Jan-IngenHousz-Institute/poroGO/kiCAD/poroGO/BOM_poroGO.xlsx

Sheet: BOM
Item name | Supplier product no | Supplier link/Item name | Quantity
Capacitor 2.2uF 0603 25V X5R 10% (Murata GRM188R61E225KA12D) | 490-10731-1-ND | https://www.digikey.nl/en/products/result?keywords=490-10731-1-ND | 80
Capacitor 10uF 0603 25V X5R 20% (Murata GRM188R61E106MA73D) | 490-7202-1-ND | https://www.digikey.nl/en/products/result?keywords=490-7202-1-ND | 30
Capacitor 10uF 0805 35V X5R 10% (TDK C2012X5R1V106K085AC) | 445-14417-1-ND | https://www.digikey.nl/en/products/result?keywords=445-14417-1-ND | 10
Capacitor 1nF 0603 50V X7R 10% (Samsung CL10B102KB8NNNC) | 1276-1018-1-ND | https://www.digikey.nl/en/products/result?keywords=1276-1018-1-ND | 10
Capacitor 1uF 0603 25V X7R 10% (Wurth 885012206076) | 732-7994-1-ND | https://www.digikey.nl/en/products/result?keywords=732-7994-1-ND | 40
Capacitor 100pF 0603 50V C0G 5% (Samsung CL10C101JB8NNNC) | 1276-1008-1-ND | https://www.digikey.nl/en/products/result?keywords=1276-1008-1-ND | 10
Resistor 5.1k 0603 1% (Bourns CR0603-FX-5101ELF) | CR0603-FX-5101ELFCT-ND | https://www.digikey.nl/en/products/result?keywords=CR0603-FX-5101ELF | 50
Resistor 6.8k 0603 1% (Bourns CR0603-FX-6801ELF) | CR0603-FX-6801ELFCT-ND | https://www.digikey.nl/en/products/result?keywords=CR0603-FX-6801ELF | 10
Resistor 187k 0603 1% (Bourns CR0603-FX-1873ELF) | 118-CR0603-FX-1873ELFCT-ND | https://www.digikey.nl/en/products/result?keywords=CR0603-FX-1873ELF | 10
Resistor 100k 0603 1% (Bourns CR0603-FX-1003ELF) | CR0603-FX-1003ELFCT-ND | https://www.digikey.nl/en/products/result?keywords=CR0603-FX-1003ELF | 20
Resistor 15R 0603 1% (Bourns CR0603-FX-15R0ELF) | CR0603-FX-15R0ELFCT-ND | https://www.digikey.nl/en/products/result?keywords=CR0603-FX-15R0ELF | 10
Resistor 1.5k 0603 1% (Bourns CR0603-FX-1501ELF) | 118-CR0603-FX-1501ELFCT-ND | https://www.digikey.nl/en/products/result?keywords=CR0603-FX-1501ELF | 10
Resistor 270k 0603 1% (Yageo RC0603FR-07270KL) | 311-270KHRCT-ND | https://www.digikey.nl/en/products/result?keywords=RC0603FR-07270KL | 10
Resistor 100R 0603 1% (Bourns CR0603-FX-1000ELF) | CR0603-FX-1000ELFCT-ND | https://www.digikey.nl/en/products/result?keywords=CR0603-FX-1000ELF | 10
Resistor 39k 0603 1% (Bourns CR0603-FX-3902ELF) | CR0603-FX-3902ELFCT-ND | https://www.digikey.nl/en/products/result?keywords=CR0603-FX-3902ELF | 10
Resistor 4.7k 0603 1% (Bourns CR0603-FX-4701ELF) | CR0603-FX-4701ELFCT-ND | https://www.digikey.nl/en/products/result?keywords=CR0603-FX-4701ELF | 20
Diode 1N4148W SOD-123 (Slkormicro) | 21853071-ND | https://www.digikey.nl/en/products/detail/smc-diode-solutions/1N4148W/6022450 | 10
Schottky diode 1N5819W 40V 1A SOD-123FL (Slkormicro) | 26112808-ND | https://www.digikey.nl/en/products/detail/smc-diode-solutions/1N5819W/15964237 | 10
LED green 0805 (Lite-On LTST-C171KGKT) | 160-1426-1-ND | https://www.digikey.nl/en/products/result?keywords=LTST-C171KGKT | 10
Inductor 10uH 3x3x1.5mm shielded (Bourns SRN3015TA-100M) | SRN3015TA-100MCT-ND | https://www.digikey.nl/en/products/result?keywords=SRN3015TA-100M | 10
Crystal 40MHz 2016 4-pin 8pF (Eaton E9X400081G08) | ECS-400-6-47B2-CKM-TR | https://www.digikey.nl/en/products/detail/ecs-inc/ecs-400-6-47b2-ckm-tr/20534431 | 10
Dual NPN/PNP transistor 40V W-DFN3020-8 (Diodes ZXTC4591AMCQTA) | 31-ZXTC4591AMCQTACT-ND | https://www.digikey.nl/en/products/result?keywords=ZXTC4591AMCQTA | 10
Spectral sensor AS7341-DLGM (ams OSRAM) | AS7341-DLGMCT-ND | https://www.digikey.nl/en/products/result?keywords=AS7341-DLGM | 10
USB ESD protection IP4234CZ6,115 (Nexperia) | 1727-1217-1-ND | https://www.digikey.nl/en/products/result?keywords=IP4234CZ6,115 | 10
Boost converter MT3608 SOT-23-6 (Olimex resale) - NOT IN STOCK | 1188-SMDICMT3608-ND | https://www.digikey.nl/en/products/result?keywords=1188-SMDICMT3608-ND | 10
Op-amp LM7321QMFX/NOPB SOT-23-5 (TI) | 296-LM7321QMFX/NOPBCT-ND | https://www.digikey.nl/en/products/result?keywords=LM7321QMFX/NOPB | 10
Sensor BME280 (Bosch Sensortec) - NOT IN STOCK, backorder | 828-1063-1-ND | https://www.digikey.nl/en/products/result?keywords=828-1063-1-ND | 10
Dual LDO 1.8V/3.3V AP7312-1833W6-7 (Diodes Inc) | AP7312-1833W6-7DICT-ND | https://www.digikey.nl/en/products/result?keywords=AP7312-1833W6-7 | 10
SoC ESP8685H4 QFN-28 (Espressif) | 1965-ESP8685H4CT-ND | https://www.digikey.nl/en/products/result?keywords=ESP8685H4 | 10
USB-C receptacle 16-pin top mount 12402012E212A (Amphenol ICC) | 664-12402012E212ACT-ND | https://www.digikey.nl/en/products/result?keywords=12402012E212A | 10
Pin header 1x02 2.54mm vertical THT (Sullins PRPC002SAAN-RC) | 35-PRPC002SAAN-RC-ND | https://www.digikey.nl/en/products/result?keywords=PRPC002SAAN-RC | 10

Sheet: Details
# | References | Value / Description | Manufacturer | MPN | Supplier | Supplier product no | Link | Qty per board | Qty (10 boards) | Order qty | Unit price EUR | Extended EUR | Stock | Notes
1 | C1,C2,C3,C4,C9,C10,C11,C12 | 2.2uF 0603 X5R 25V 10% | Murata | GRM188R61E225KA12D | DigiKey NL | 490-10731-1-ND | https://www.digikey.nl/en/products/result?keywords=490-10731-1-ND | 8 | 80 | 80 | €0.0306 | €2.45 | 156,080 | Schematic MPN GRT188R61H225KE13D (50V) is in stock at DigiKey but costs 0.0656 EUR; 25V rating is sufficient for 3.3V/5V rails. Price at 50+ break.
2 | C6,C13,C201 | 10uF 0603 X5R 25V 20% | Murata | GRM188R61E106MA73D | DigiKey NL | 490-7202-1-ND | https://www.digikey.nl/en/products/result?keywords=490-7202-1-ND | 3 | 30 | 30 | €0.1410 | €4.23 | 302,052 | Schematic MPN GRM188R61E106MA73J out of stock everywhere; MA73D is the same part with 20% tolerance. C13 in schematic wrongly carries the 2.2uF MPN. Farnell 1907503 lists it at ~0.0955 EUR (MOQ 10) but could not be verified (site blocked).
3 | C203 | 10uF 0805 X5R 35V 10% (boost output, up to 28V) | TDK | C2012X5R1V106K085AC | DigiKey NL | 445-14417-1-ND | https://www.digikey.nl/en/products/result?keywords=445-14417-1-ND | 1 | 10 | 10 | €0.2480 | €2.48 | 137,592 | No MPN in schematic; 35V rating chosen because boost output goes to 20-28V. DigiKey flags this TDK part NRND; active alternative Taiyo Yuden GMK212BBJ106MG-T (587-4894-1-ND) 0.273 EUR.
4 | C202 | 1nF 0603 X7R 50V 10% | Samsung | CL10B102KB8NNNC | DigiKey NL | 1276-1018-1-ND | https://www.digikey.nl/en/products/result?keywords=1276-1018-1-ND | 1 | 10 | 10 | €0.0290 | €0.29 | 1,036,225 | No MPN in schematic. Farnell 3013403 ~0.0163 EUR (unverified).
5 | C204,C205,C206,C208 | 1uF 0603 X7R 25V 10% | Wurth Elektronik | 885012206076 | DigiKey NL | 732-7994-1-ND | https://www.digikey.nl/en/products/result?keywords=732-7994-1-ND | 4 | 40 | 50 | €0.0398 | €1.99 | 72,775 | No MPN in schematic; Murata GRM188R61E105KA12D and Samsung CL10A105KA8NNNC out of stock. Ordering 50 (50+ break, 1.99 EUR) is cheaper than 40 at 0.057 (2.28 EUR).
6 | C207 | 100pF 0603 C0G/NP0 50V 5% | Samsung | CL10C101JB8NNNC | DigiKey NL | 1276-1008-1-ND | https://www.digikey.nl/en/products/result?keywords=1276-1008-1-ND | 1 | 10 | 10 | €0.0280 | €0.28 | 802,543 | No MPN in schematic. Farnell 3013439 ~0.0164 EUR (unverified).
7 | R2,R12,R13,R29,R30 | 5.1 kOhm 0603 1% 0.1W | Bourns | CR0603-FX-5101ELF | DigiKey NL | CR0603-FX-5101ELFCT-ND | https://www.digikey.nl/en/products/result?keywords=CR0603-FX-5101ELF | 5 | 50 | 50 | €0.0102 | €0.51 | 49,626 | Designer's MPN; 50+ price break.
8 | R201 | 6.8 kOhm 0603 1% 0.1W | Bourns | CR0603-FX-6801ELF | DigiKey NL | CR0603-FX-6801ELFCT-ND | https://www.digikey.nl/en/products/result?keywords=CR0603-FX-6801ELF | 1 | 10 | 10 | €0.0180 | €0.18 | 50,648
9 | R202 | 187 kOhm 0603 1% 0.1W | Bourns | CR0603-FX-1873ELF | DigiKey NL | 118-CR0603-FX-1873ELFCT-ND | https://www.digikey.nl/en/products/result?keywords=CR0603-FX-1873ELF | 1 | 10 | 10 | €0.0230 | €0.23 | 24,971
10 | R203,R204 | 100 kOhm 0603 1% 0.1W | Bourns | CR0603-FX-1003ELF | DigiKey NL | CR0603-FX-1003ELFCT-ND | https://www.digikey.nl/en/products/result?keywords=CR0603-FX-1003ELF | 2 | 20 | 20 | €0.0180 | €0.36 | 1,013,144
11 | R205 | 15 Ohm 0603 1% 0.1W | Bourns | CR0603-FX-15R0ELF | DigiKey NL | CR0603-FX-15R0ELFCT-ND | https://www.digikey.nl/en/products/result?keywords=CR0603-FX-15R0ELF | 1 | 10 | 10 | €0.0200 | €0.20 | 57,113
12 | R206 | 1.5 kOhm 0603 1% 0.1W | Bourns | CR0603-FX-1501ELF | DigiKey NL | 118-CR0603-FX-1501ELFCT-ND | https://www.digikey.nl/en/products/result?keywords=CR0603-FX-1501ELF | 1 | 10 | 10 | €0.0180 | €0.18 | 159,579
13 | R207 | 270 kOhm 0603 1% 0.1W | Yageo | RC0603FR-07270KL | DigiKey NL | 311-270KHRCT-ND | https://www.digikey.nl/en/products/result?keywords=RC0603FR-07270KL | 1 | 10 | 10 | €0.0210 | €0.21 | 235,572
14 | R208 | 100 Ohm 0603 1% 0.1W | Bourns | CR0603-FX-1000ELF | DigiKey NL | CR0603-FX-1000ELFCT-ND | https://www.digikey.nl/en/products/result?keywords=CR0603-FX-1000ELF | 1 | 10 | 10 | €0.0180 | €0.18 | 718,115
15 | R210 | 39 kOhm 0603 1% 0.1W | Bourns | CR0603-FX-3902ELF | DigiKey NL | CR0603-FX-3902ELFCT-ND | https://www.digikey.nl/en/products/result?keywords=CR0603-FX-3902ELF | 1 | 10 | 10 | €0.0230 | €0.23 | 37,369
16 | R211,R212 | 4.7 kOhm 0603 1% 0.1W | Bourns | CR0603-FX-4701ELF | DigiKey NL | CR0603-FX-4701ELFCT-ND | https://www.digikey.nl/en/products/result?keywords=CR0603-FX-4701ELF | 2 | 20 | 20 | €0.0180 | €0.36 | 267,757
17 | D1 | 1N4148W 75V 150mA switching diode SOD-123 | Shenzhen Slkormicro | 1N4148W | DigiKey NL | 21853071-ND | https://www.digikey.nl/en/products/result?keywords=21853071-ND | 1 | 10 | 10 | €0.0300 | €0.30 | 75,674 | Direct DigiKey stock (not marketplace). Schematic MPN MCC 1N4148W-TP: 0 stock at Farnell; brand alternative SMC 1N4148W (1655-1N4148WCT-ND) 0.071 EUR.
18 | D201 | Schottky 40V 1A SOD-123F/FL (boost output diode) | Shenzhen Slkormicro | 1N5819W | DigiKey NL | 26112808-ND | https://www.digikey.nl/en/products/result?keywords=26112808-ND | 1 | 10 | 10 | €0.0390 | €0.39 | 24,305 | Schematic value only says 'Schottky >100mA, SOD-123F'. Brand alternatives: SMC 1N5819W (1655-1N5819WCT-ND) 0.119 EUR; onsemi MBR140SFT1G 0.317 EUR.
19 | D3 | LED green 0805 | Lite-On | LTST-C171KGKT | DigiKey NL | 160-1426-1-ND | https://www.digikey.nl/en/products/result?keywords=LTST-C171KGKT | 1 | 10 | 10 | €0.0930 | €0.93 | 436,047 | Designer's MPN.
20 | L201 | 10uH power inductor, Isat 0.75A, 3x3x1.5mm | Bourns | SRN3015TA-100M | DigiKey NL | SRN3015TA-100MCT-ND | https://www.digikey.nl/en/products/result?keywords=SRN3015TA-100M | 1 | 10 | 10 | €0.2810 | €2.81 | ~1,080 | Designer's part (from schematic description). Isat only 0.75A; check against MT3608 peak switch current. Farnell 2616870 ~0.347 EUR (unverified).
21 | Y2 | 40 MHz crystal, 2.0x1.6mm 4-pad, 8pF, +/-10ppm tol, +/-15ppm stability | Eaton | E9X400081G08 | DigiKey NL | 283-E9X400081G08CT-ND | https://www.digikey.nl/en/products/result?keywords=E9X400081G08 | 1 | 10 | 10 | €0.1830 | €1.83 | 2,655 | Schematic MPN ECS-400-8-47B2-CKM-TR is out of stock at DigiKey (ETA Jan 2027); Farnell 4757393 ~0.313 EUR unverified. Eaton stability is +/-15ppm vs +/-10ppm; for strict +/-10/10 use Kyocera CX2016SA40000D0FLJG1 (0.28 EUR, DigiKey).
22 | Q201 | Complementary NPN+PNP pair, 40V, 2.5A/2A, W-DFN3020-8 (3x2mm) | Diodes Inc | ZXTC4591AMCQTA | DigiKey NL | 31-ZXTC4591AMCQTACT-ND | https://www.digikey.nl/en/products/result?keywords=ZXTC4591AMCQTA | 1 | 10 | 10 | €1.0020 | €10.02 | 3,540 | PART NOT SPECIFIED IN SCHEMATIC and Q201 is unrouted on the PCB. Chosen as the only >=40V complementary pair in the W-DFN3020-8 package; datasheet pinout (B1/E1/B2/E2 small pads, C1/C2 large pads) matches the footprint. Verify pin mapping before ordering.
23 | U1 | 11-channel spectral sensor, OLGA-8 | ams OSRAM | AS7341-DLGM | DigiKey NL | AS7341-DLGMCT-ND | https://www.digikey.nl/en/products/result?keywords=AS7341-DLGM | 1 | 10 | 10 | €6.3100 | €63.10 | 7,110 | Schematic value says AS7341-DLGT, MPN field says AS7341-DLGM (same die, DLGM is the standard orderable). DigiKey status NRND. Farnell only ~5 pcs.
24 | U2 | 2-ch USB 2.0 ESD protection, SOT-457 (SC-74) | Nexperia | IP4234CZ6,115 | DigiKey NL | 1727-1217-1-ND | https://www.digikey.nl/en/products/result?keywords=IP4234CZ6,115 | 1 | 10 | 10 | €0.3470 | €3.47 | 34,341 | Mouser 771-IP4234CZ6115 ~0.295 USD (unverified). Farnell: no stock.
25 | U201 | MT3608 1.2MHz boost converter, SOT-23-6 | Aerosemi (sold by Olimex) | SMD IC MT3608 | DigiKey NL | 1188-SMDICMT3608-ND | https://www.digikey.nl/en/products/result?keywords=1188-SMDICMT3608-ND | 1 | 10 | 10 | €0.2200 | €2.20 | 0 (7 pcs due 17 Sep 2026, 3 pcs 7 Oct 2026) | MT3608 is not stocked by DigiKey, Mouser or Farnell. Only listing is Olimex resale at DigiKey, currently 0 stock. Not a drop-in: AP3012KTR-G1 (DigiKey AP3012KTR-G1DICT-ND, 0.193 EUR, 74k stock) or TPS61041DBVR match pins 1-4 but are SOT-23-5 (VIN lands on pad 6 = NC) and use a 1.25V FB reference instead of 0.6V, so the divider (R201/R202/R207/R210) must be recalculated. Otherwise source MT3608 from LCSC.
26 | U202 | Rail-to-rail op-amp, SOT-23-5 (automotive grade of LM7321MF) | Texas Instruments | LM7321QMFX/NOPB | DigiKey NL | 296-LM7321QMFX/NOPBCT-ND | https://www.digikey.nl/en/products/result?keywords=LM7321QMFX/NOPB | 1 | 10 | 10 | €2.0400 | €20.40 | 9,589 | Schematic LM7321MF/NOPB is obsolete. LM7321MFX/NOPB (296-35181-1-ND) 2.157 EUR is the plain commercial grade; the Q (AEC-Q100) version is pin/spec identical and cheaper.
27 | U3 | Humidity/pressure/temperature sensor, LGA-8 2.5x2.5mm | Bosch Sensortec | BME280 | DigiKey NL | 828-1063-1-ND | https://www.digikey.nl/en/products/result?keywords=828-1063-1-ND | 1 | 10 | 10 | €2.9300 | €29.30 | 0 (10,000 past due, est. 19 Aug 2026; 12-wk lead) | No stock at DigiKey, Mouser (119k due 20 Nov 2026) or Farnell (not listed). DigiKey shows marketplace partners may have stock; check on the product page. Price is DigiKey's list at qty 10.
28 | U5 | 150mA dual LDO 1.8V/3.3V, TSOT-23-6 | Diodes Inc | AP7312-1833W6-7 | DigiKey NL | AP7312-1833W6-7DICT-ND | https://www.digikey.nl/en/products/result?keywords=AP7312-1833W6-7 | 1 | 10 | 10 | €0.3700 | €3.70 | 670 | Designer's MPN. Farnell 2138328 ~0.33 EUR (unverified), Mouser ~0.39 USD (unverified).
29 | U8 | ESP32-C3 core SoC with 4MB flash, QFN-28 4x4mm | Espressif | ESP8685H4 | DigiKey NL | 1965-ESP8685H4CT-ND | https://www.digikey.nl/en/products/result?keywords=ESP8685H4 | 1 | 10 | 10 | €2.1000 | €21.00 | 2,921 | Designer's MPN. Mouser 356-ESP8685H4 ~2.45 USD (unverified). Farnell: not listed.
30 | J2 | USB 2.0 Type-C receptacle, 16 pin, SMT + 4 THT shell posts | Amphenol ICC | 12402012E212A | DigiKey NL | 664-12402012E212ACT-ND | https://www.digikey.nl/en/products/result?keywords=12402012E212A | 1 | 10 | 10 | €0.5320 | €5.32 | 92,746 | Designer's MPN; verified footprint-compatible with KiCad HRO TYPE-C-31-M-12 footprint (8.64x4.18mm shell posts, 0.5mm pitch, 0.65mm NPTH). Rear post slot in KiCad footprint is 0.2mm shorter than Amphenol drawing (minor). Alternative GCT USB4105-GF-A 0.579 EUR.
31 | P201 | 2-pin 2.54mm male header, vertical, through-hole | Sullins | PRPC002SAAN-RC | DigiKey NL | 35-PRPC002SAAN-RC-ND | https://www.digikey.nl/en/products/result?keywords=PRPC002SAAN-RC | 1 | 10 | 10 | €0.0340 | €0.34 | 49,279 | Piezo pump connector. No MPN in schematic.
 |  |  |  |  |  |  |  |  |  | Total (10 boards) |  | €179.47

Sheet: Excluded (DNP)
Reference | Value | Reason
D2 | LED 0805 | Excluded from BOM in schematic (in_bom = no)
J1 | Conn_01x08 Molex 5034800800 FFC | Excluded from BOM and DNP in schematic; not placed on PCB
J4 | Conn_01x02_Pin header | Excluded from BOM and DNP in schematic
J5 | secondBoard PinSocket 1x04 1.27mm | Excluded from BOM and DNP in schematic; not placed on PCB
R3 | 0R 0603 | Excluded from BOM and DNP
R4 | 10K 0603 | DNP in schematic; not placed on PCB
R5 | 10K 0603 | DNP in schematic; not placed on PCB
R6 | 0R 0603 | Excluded from BOM and DNP
R7 | 10K 0603 | Excluded from BOM and DNP
R8 | 10K 0603 | Excluded from BOM and DNP
SW2 | SW_Push EVQP2 | Excluded from BOM and DNP
MH201-MH205 | Mounting holes | Board-only, no part
#PWR*, #FLG* | Power symbols | Not physical parts
