Jan-IngenHousz-Institute/poroGO/cad/poroGO_v002.FCStd

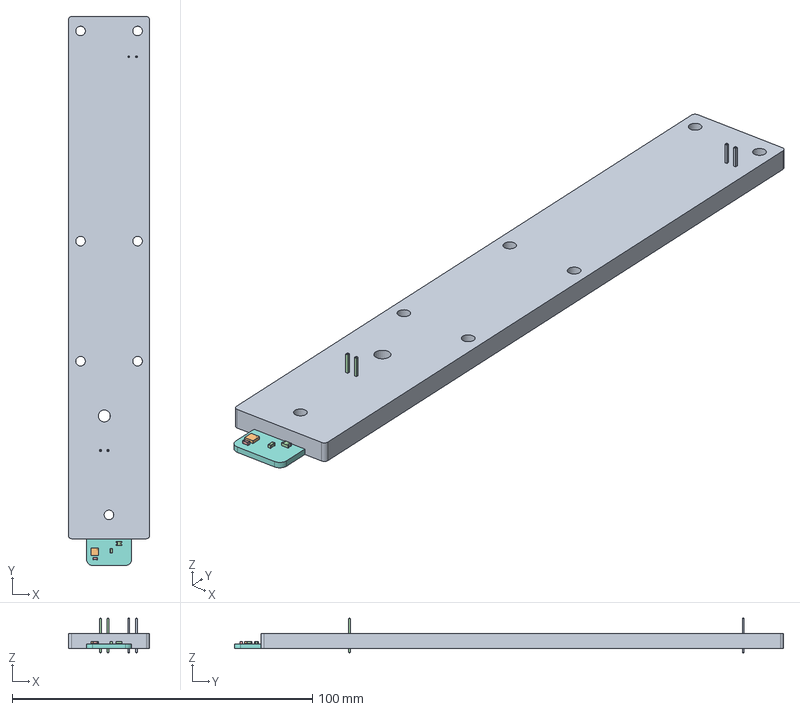
[picture p1: CAD file, 2026-09-18]
cad/poroGO_v002.FCStd
27.0 x 182.9 x 11.5 mm
TSOT-23-002
R_0603_1608Metric018
C_0603_1608Metric018
C_0603_1608Metric020
R_0603_1608Metric020
SW_SPST_EVQP2_ShortPushTravel_H2.1mm002
R_0603_1608Metric022
C_0603_1608Metric022
R_0603_1608Metric024
R_0603_1608Metric026
R_0603_1608Metric028
C_0603_1608Metric024
R_0603_1608Metric030
C_0603_1608Metric026
R_0603_1608Metric032
C_0603_1608Metric028
PinHeader_1x02_P254mm_Vertical001
D_SOD_123F
QFN-28-1EP_4x4mm_Pitch0.4mm001
R_0603_1608Metric034
R_0603_1608Metric036
C_0603_1608Metric030
R_0603_1608Metric038
C_0603_1608Metric032
C_0603_1608Metric034
D_SOD-125
R_0603_1608Metric040
D_0807
R_0603_1608Metric042
R_0603_1608Metric044
L_1210_3225Metric
MicroCrystal_CC8V_T1A001
SC-74-6_1.55x2.9mm_P0.95mm002
C_0603_1608Metric036
DFN-8-1EP_2x3mm_Pitch0.5mm
C_0603_1608Metric038
C_0603_1608Metric040
C_0603_1608Metric042
C_0603_1608Metric044
R_0603_1608Metric046
R_0603_1608Metric048
SOT-23-5
R_0603_1608Metric050
PinHeader_1x02_P254mm_Vertical002
R_0603_1608Metric052
C_0805_2012Metric
R_0603_1608Metric054
C_0603_1608Metric046
R_0603_1608Metric056
Bosch_LGA_8_25x25mm_P065mm_ClockwisePinNumbering
D_0808
C_0603_1608Metric048
R_0603_1608Metric058
SOT-23-6
C_0603_1608Metric050
poroGO_PCB
