Jan-IngenHousz-Institute/poroGO/kiCAD/poroGO/CO2Dot_PCB_v003.step

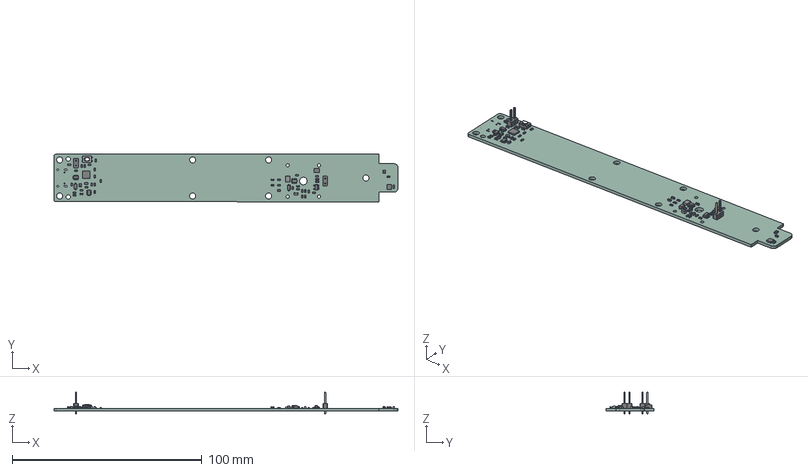
[picture p2: CAD file, 2026-09-18]
kiCAD/poroGO/CO2Dot_PCB_v003.step
181.1 x 25.0 x 11.5 mm
TSOT-23-6
R_0603_1608Metric x 21
C_0603_1608Metric x 17
SW_SPST_EVQP2_ShortPushTravel_H2.1mm
PinHeader_1x02_P254mm_Vertical x 2
D_SOD_123F
QFN-28-1EP_4x4mm_Pitch0.4mm
D_SOD-123
D_0805 x 2
L_1210_3225Metric
MicroCrystal_CC8V_T1A
SC-74-6_1.55x2.9mm_P0.95mm
DFN-8-1EP_2x3mm_Pitch0.5mm
SOT-23-5
C_0805_2012Metric
Bosch_LGA_8_25x25mm_P065mm_ClockwisePinNumbering
SOT-23-6
poroGO_PCB
