Jan-IngenHousz-Institute/poroGO/cad/poroGO_v001.FCStd

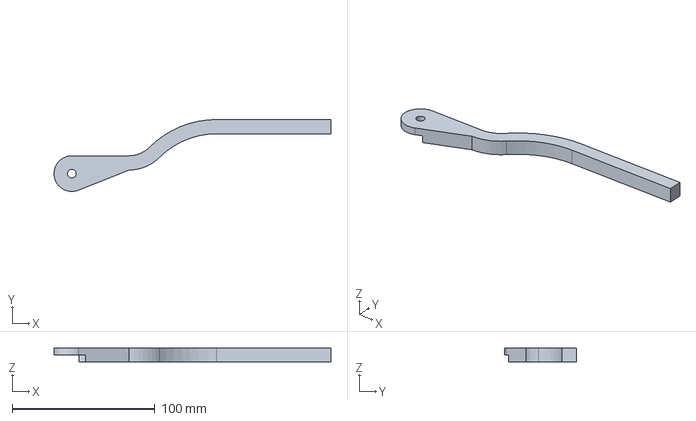
[picture p3: CAD file, 2026-09-17, an earlier design]
cad/poroGO_v001.FCStd
193.7 x 50.4 x 10.0 mm
