Jan-IngenHousz-Institute/poroGO/kiCAD/piezzoPWM/250214_Piezzo+DCDCMT3608_PWM.kicad_pcb

## KiCad design kiCAD/piezzoPWM/250214_Piezzo+DCDCMT3608_PWM.kicad_pcb (2026-09-17)

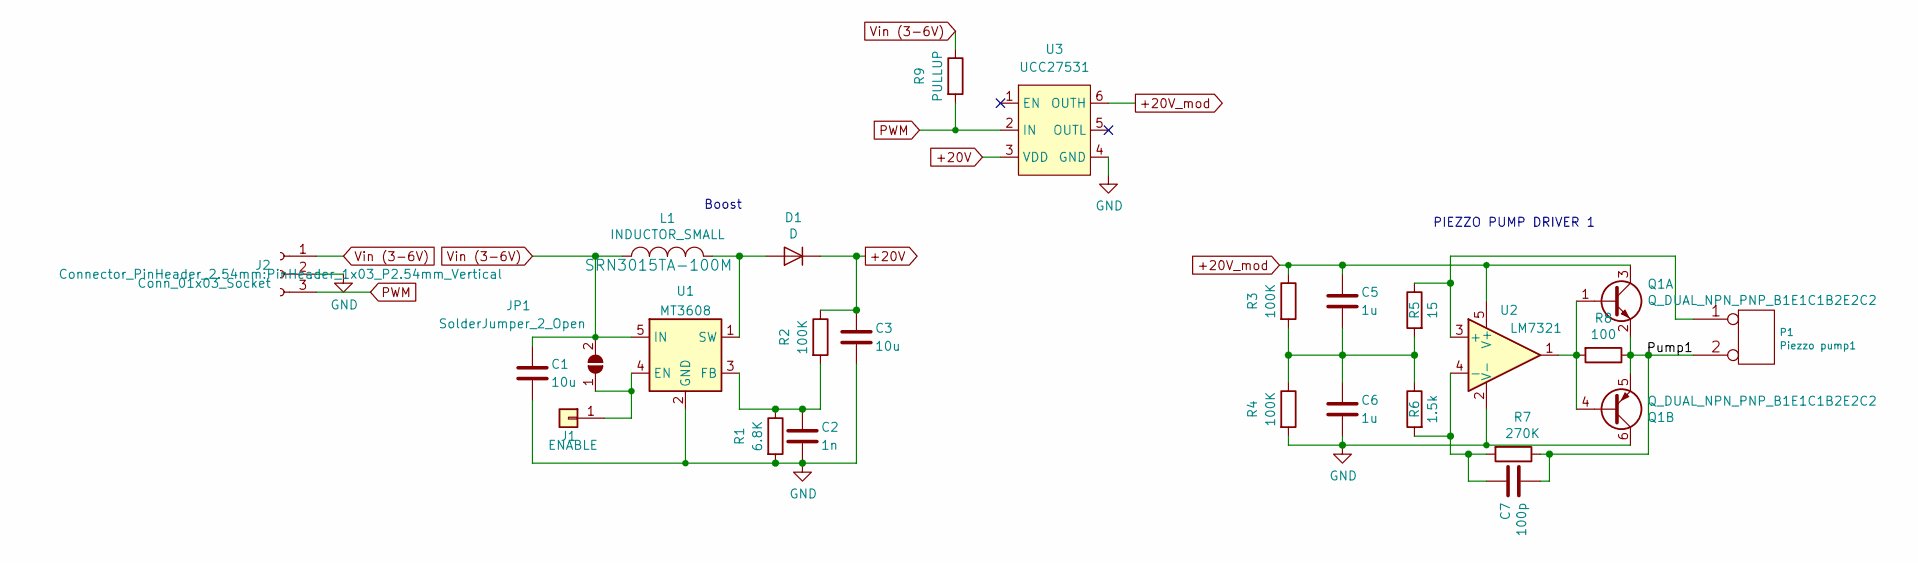
[picture p3: schematic 250214_Piezzo+DCDCMT3608_PWM.kicad_sch]

Parts:
C1: 10u; C_0603_1608Metric
C2: 1n; C_0603_1608Metric
C3: 10u; C_0805_2012Metric
C5, C6: 1u; C_0603_1608Metric
C7: 100p; C_0603_1608Metric
D1: D; D_SOD-123F
J1: ENABLE; SolderWirePad_single_SMD_2x2mm
J2: Conn_01x03_Socket; PinHeader_1x03_P2.54mm_Vertical
JP1: SolderJumper_2_Open; SolderJumper-2_P0.8mm_Open_TrianglePad0.8x1.6mm
L1: INDUCTOR_SMALL; L_1210_3225Metric
P1: Piezzo pump1; PinHeader_1x02_P2.54mm_Vertical
Q1: Q_DUAL_NPN_PNP_B1E1C1B2E2C2; W-DFN3020-8_3x2mm_P0.65mm
R1: 6.8K; R_0603_1608Metric
R2, R3, R4: 100K; R_0603_1608Metric
R5: 15; R_0603_1608Metric
R6: 1.5k; R_0603_1608Metric
R7: 270K; R_0603_1608Metric
R8: 100; R_0603_1608Metric
R9: PULLUP; R_0603_1608Metric
U1: MT3608; SOT-23-6
U2: LM7321; SOT-23-5
U3: UCC27531; TSOT-23-6_HandSoldering

Connections:
+20V: C3.1, D1.1 (K), R2.1, U3.3 (VDD)
+20V_mod: C5.1, Q1.3 (C1), R3.1, U2.5 (V+), U3.6 (OUTH)
/Pump1: C7.2, P1.2 (PM), Q1.2 (E1), Q1.5 (E2), R7.1, R8.1
GND: C1.2, C2.2, C3.2, C6.2, J2.2, Q1.6 (C2), R1.2, R4.2, U1.2 (GND), U2.2 (V-), U3.4 (GND)
unnamed: C5.2, C6.1, R3.2, R4.1, R5.2, R6.1
unnamed: D1.2 (A), L1.2, U1.1 (SW)
unnamed: J1.1, JP1.1 (A), U1.4 (EN)
unnamed: P1.1, R5.1, U2.3 (+)
unnamed: Q1.1 (B1), Q1.4 (B2), R8.2, U2.1
unnamed: C2.1, R1.1, R2.2, U1.3 (FB)
unnamed: C7.1, R6.2, R7.2, U2.4 (-)
PWM: J2.3, R9.2, U3.2 (IN)
Vin (3-6V): C1.1, J2.1, JP1.2 (B), L1.1, R9.1, U1.5 (IN)

Notes on the sheet:
PIEZZO PUMP DRIVER 1
Boost

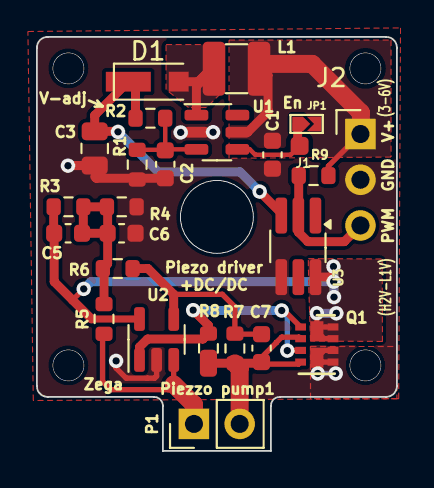
[picture p4: board 250214_Piezzo+DCDCMT3608_PWM.kicad_pcb from above]

Board: 2 copper layers, 20.0 x 23.0 mm, 25 parts (0 on the bottom side), 13 nets.
